gabesk/xmascard_lattice/board/schematic.pdf

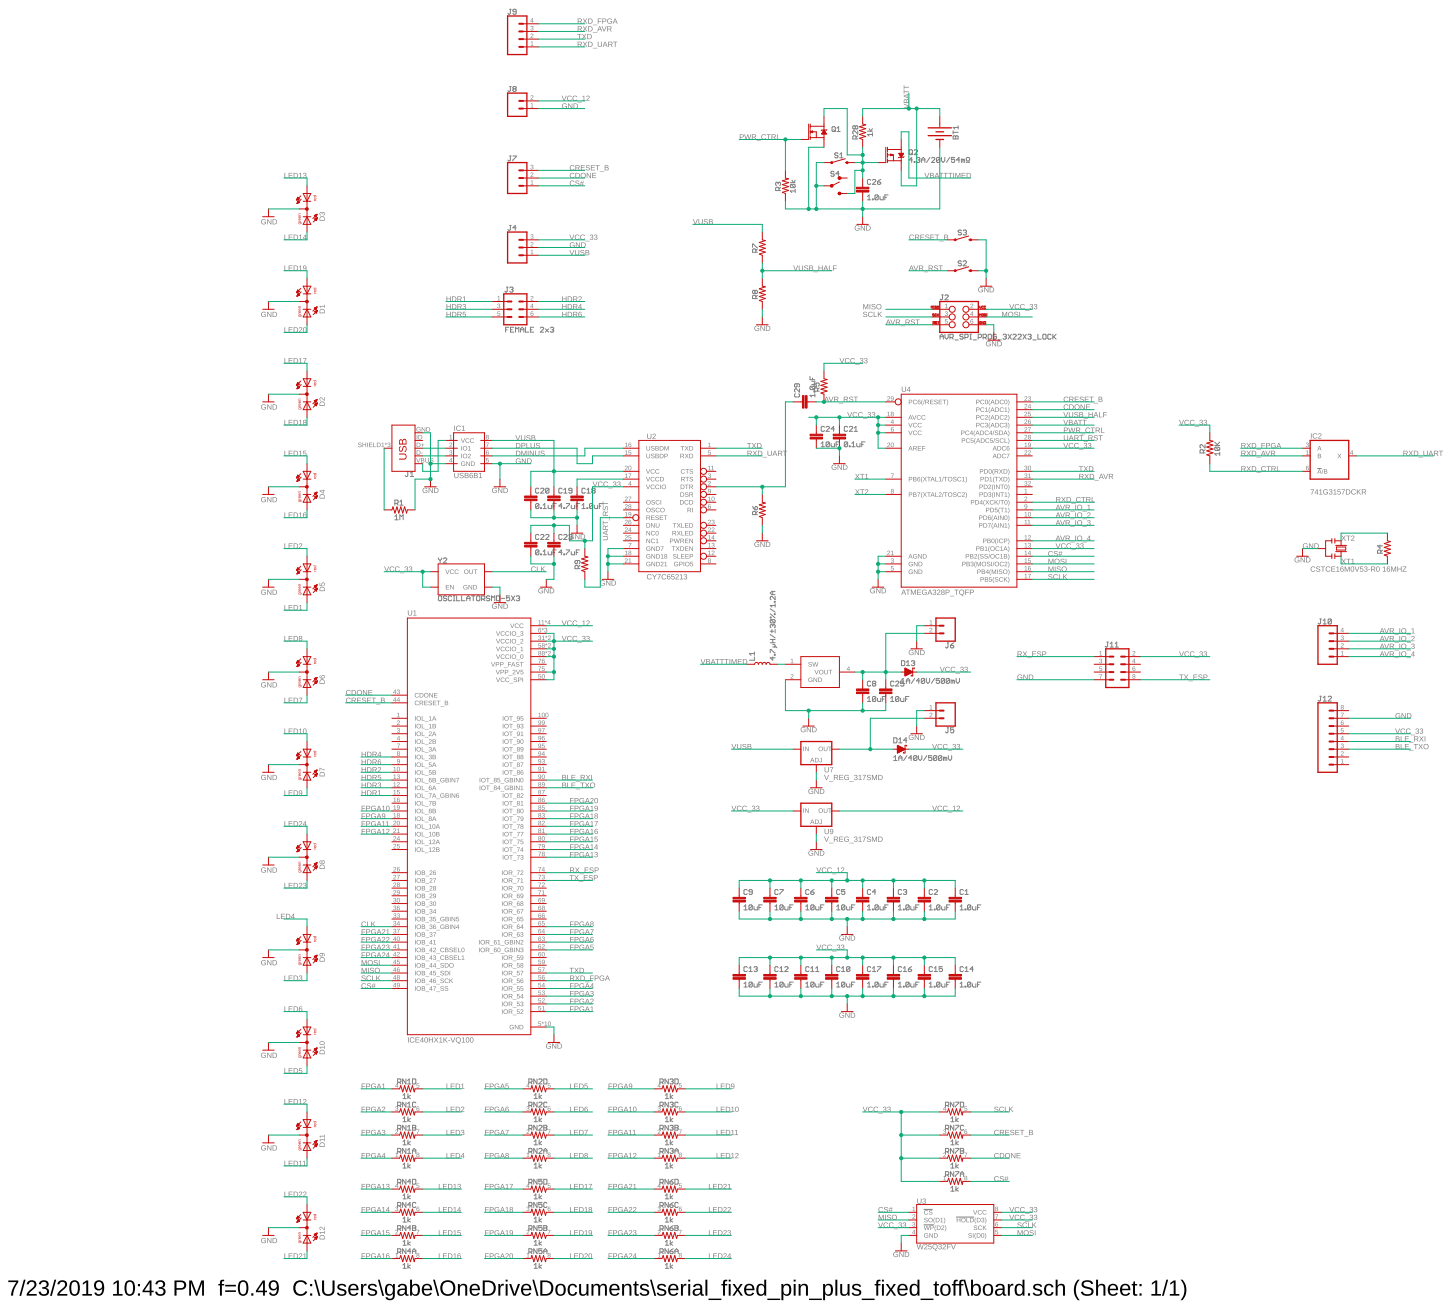
[picture p1: page 1]
