gabesk/xmascard_lattice/board/board.pdf

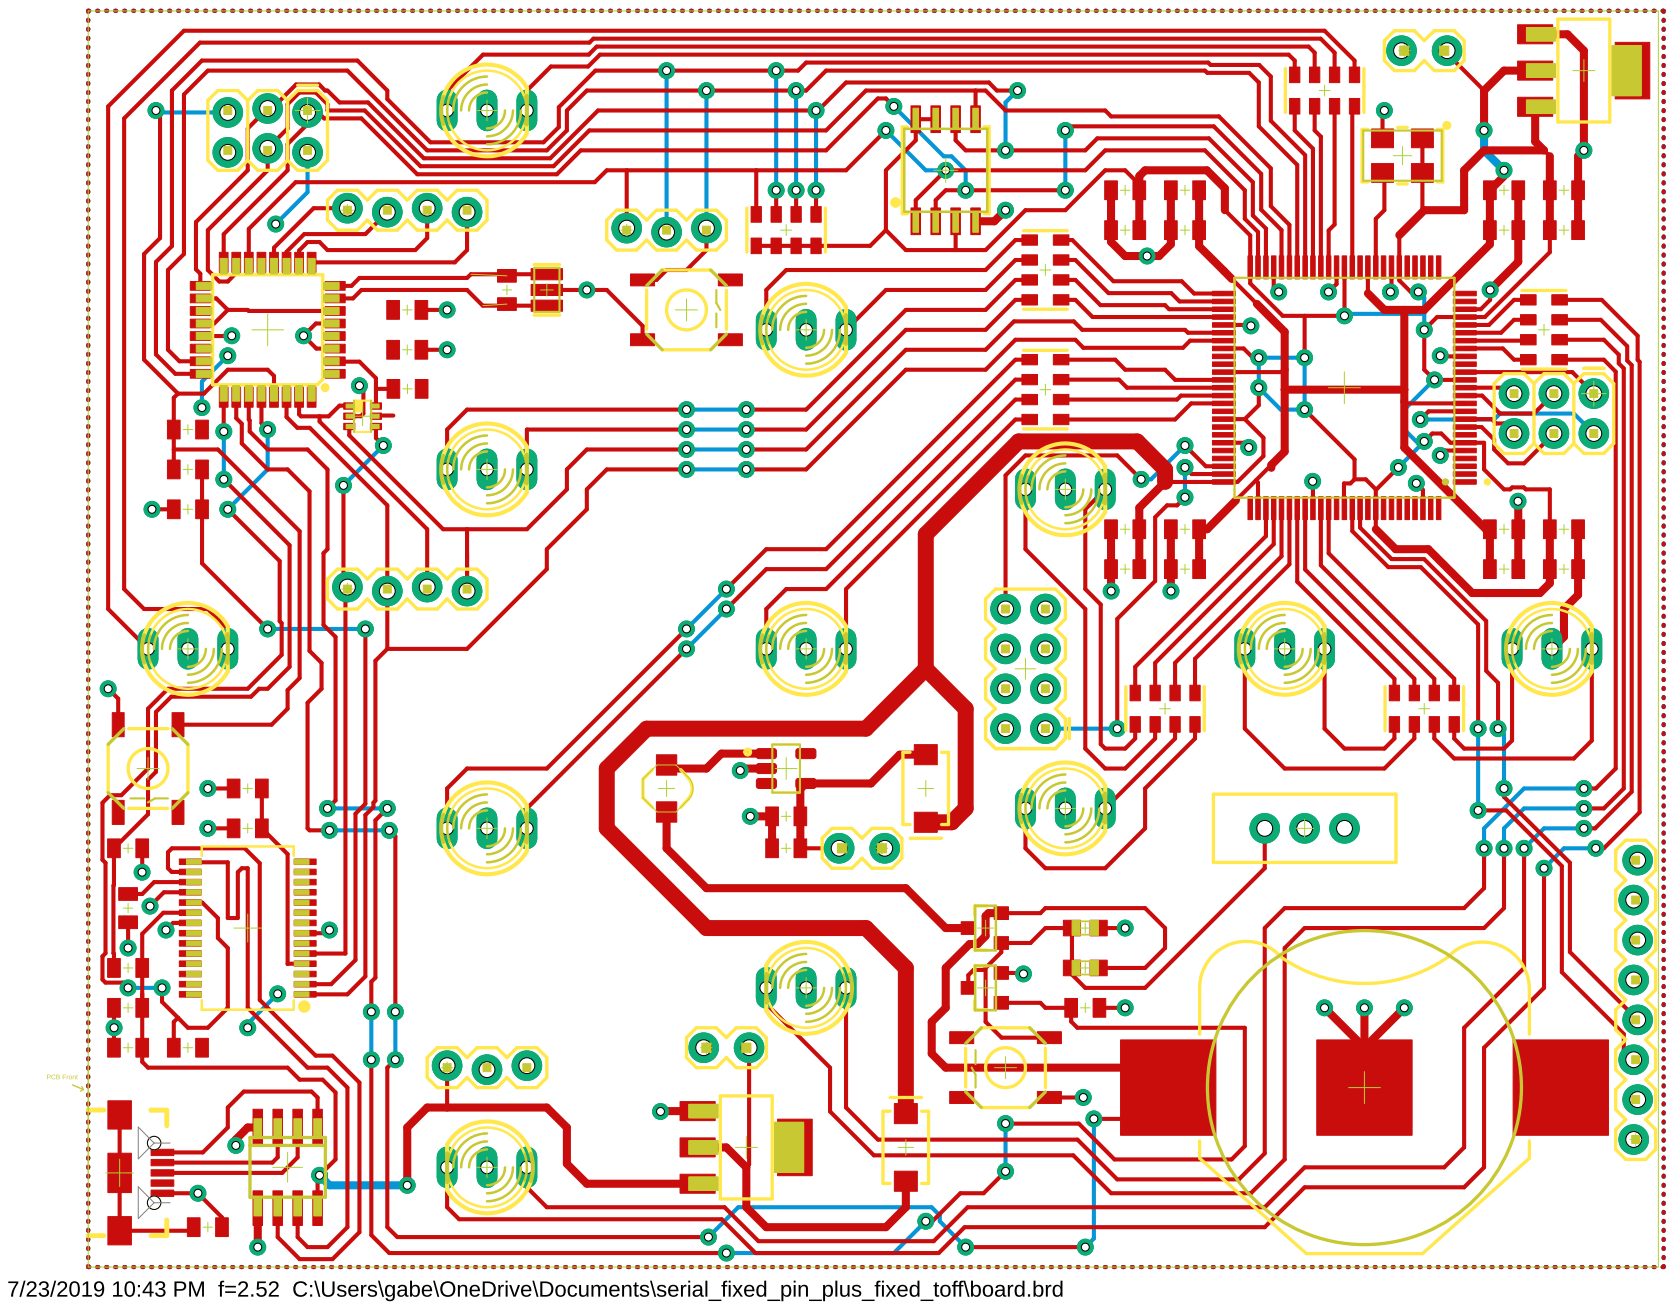
[picture p2: page 1]
