gabesk/xmascard_lattice/board/board.brd

## EAGLE design board/board.brd (2019-07-24)

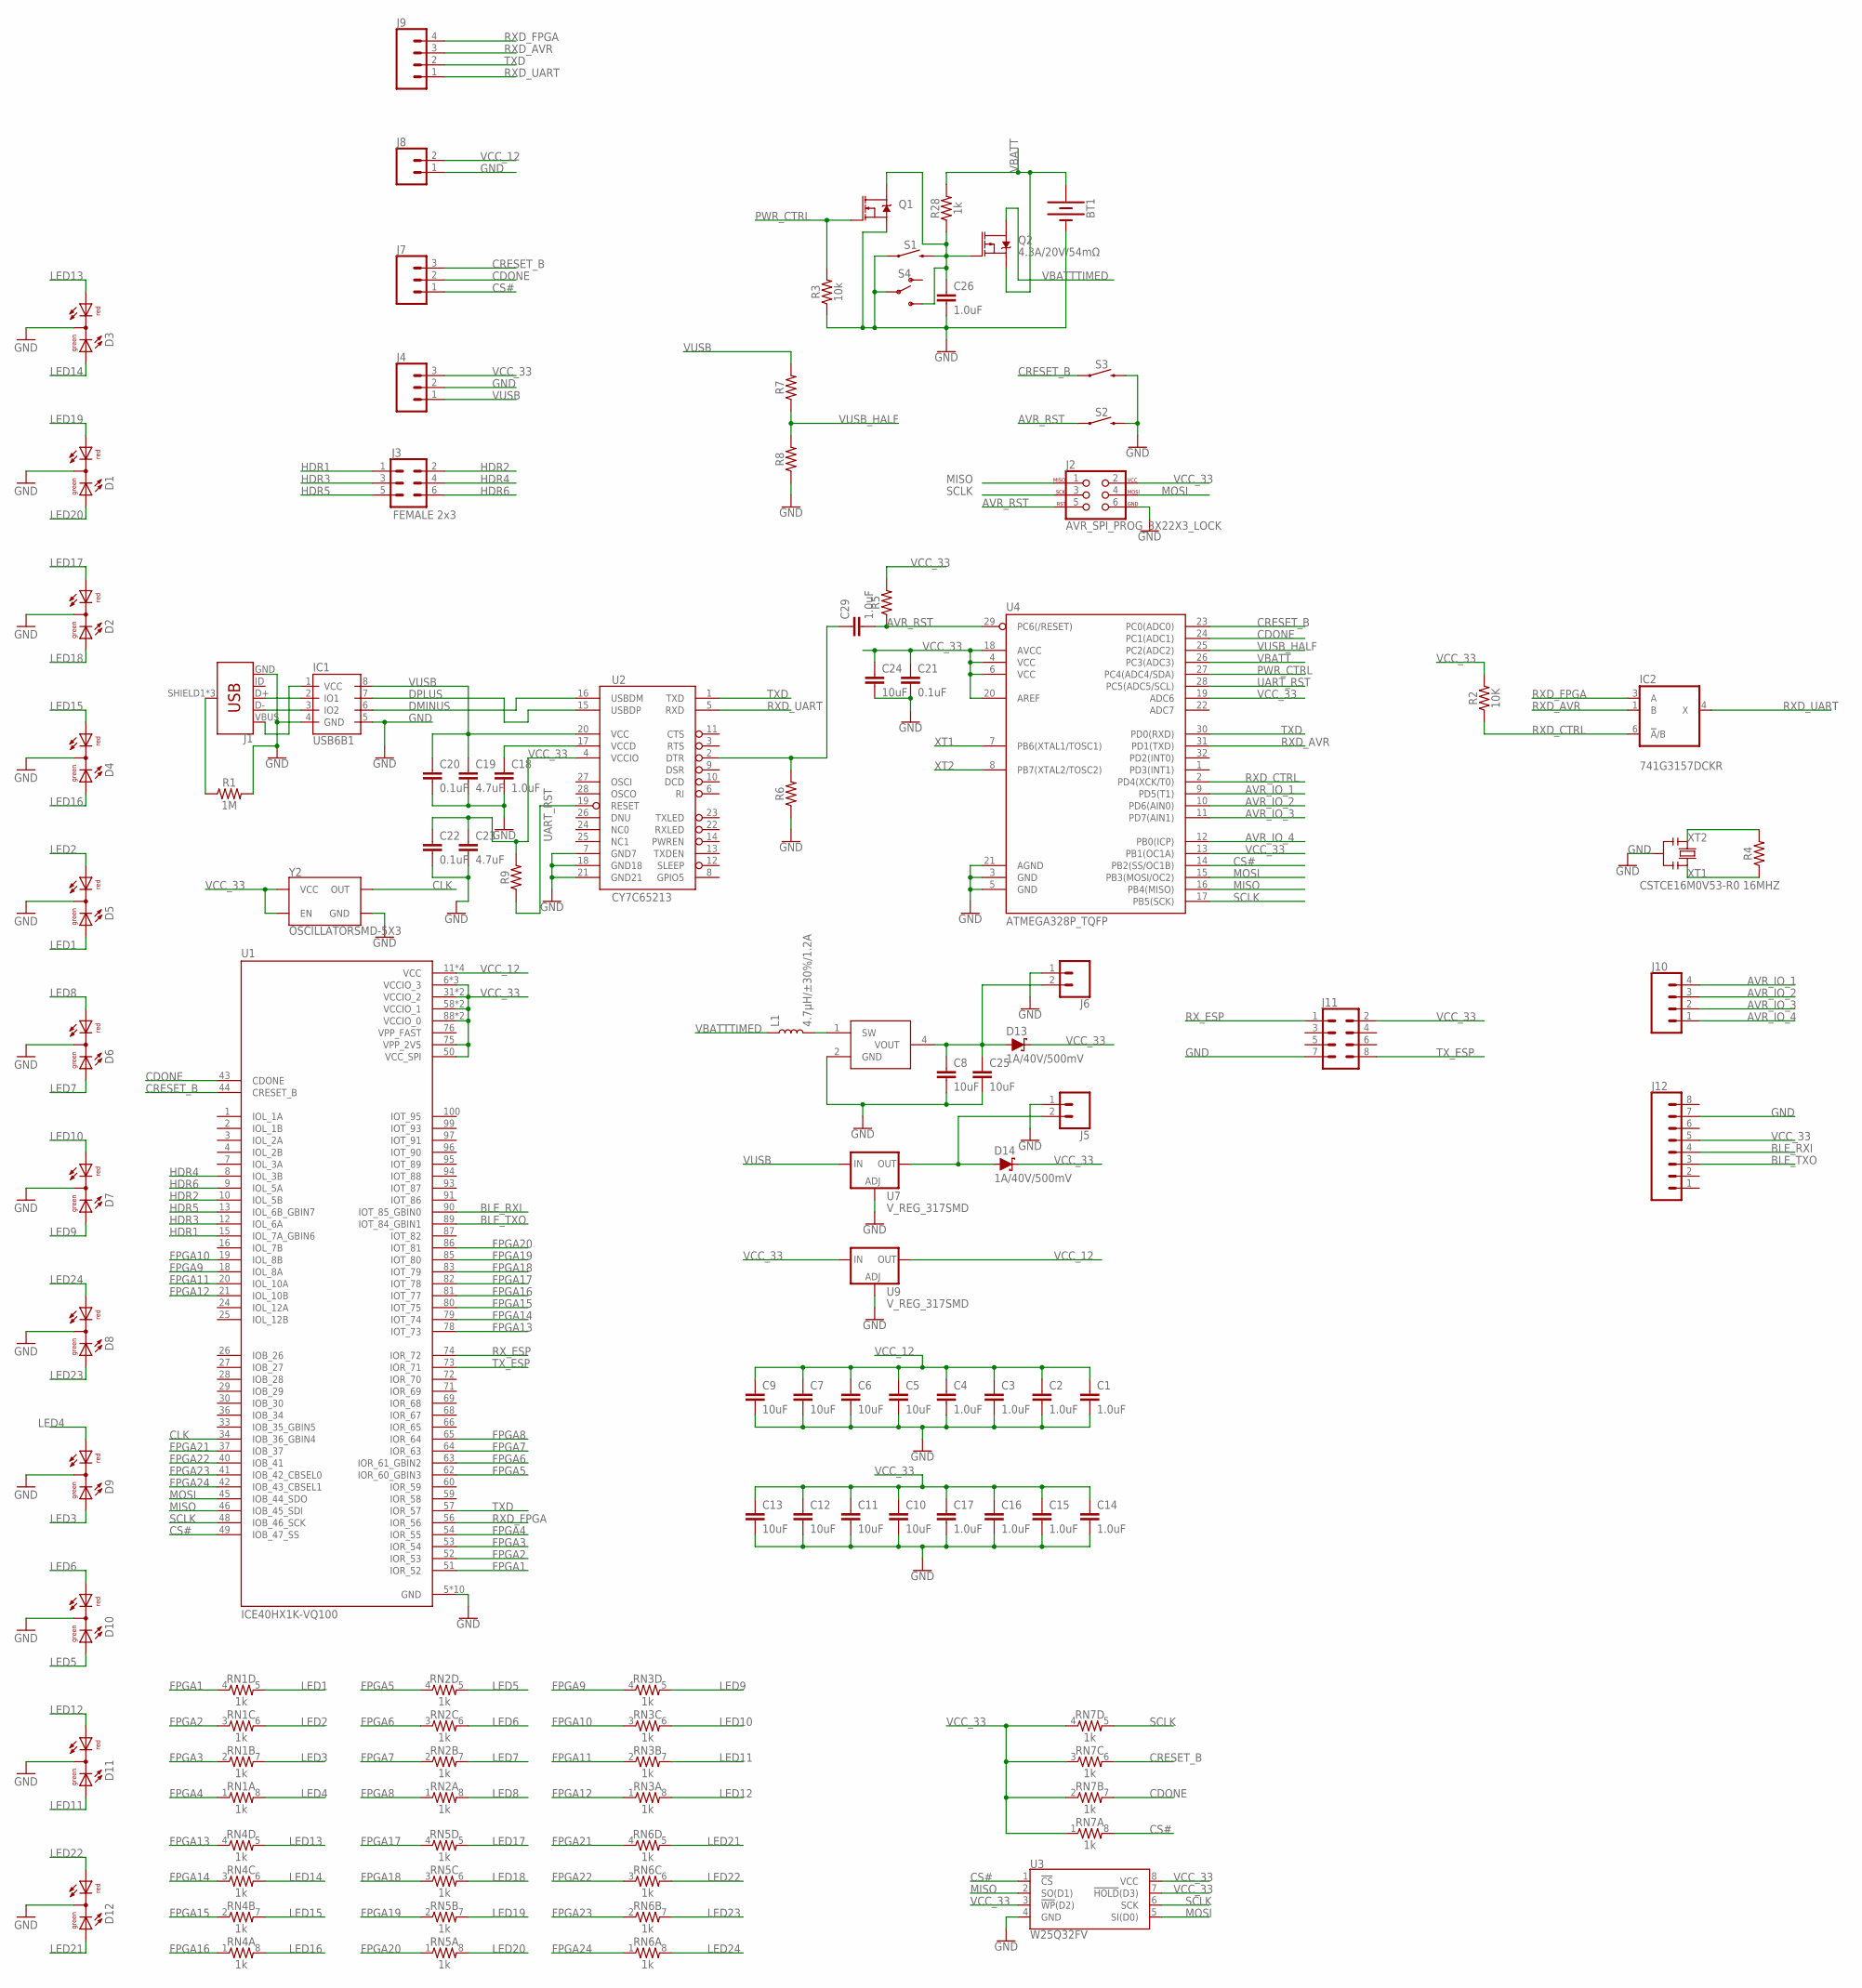
[picture p3: schematic board.sch]

Parts:
BT1: BATTERY-20MM_SMD; BATTCON_20MM
C1, C2, C3, C4, C14, C15, C16, C17, C18, C29: 1.0uF; 0805
C5, C6, C7, C8, C9, C10, C11, C12, C13, C24, C25: 10uF; 0805
C19, C23: 4.7uF; 0805
C20, C21, C22: 0.1uF; 0805
C26: 1.0uF; 0603
D1, D2, D3, D4, D5, D6, D7, D8, D9, D10, D11, D12: DUOLED5MM
D13, D14: 1A/40V/500mV; SMA-DIODE
IC1: USB6B1; SO08
IC2: 741G3157DCKR; DCK_R-PDSO-G6
J1: USB_MICRO-B_FEMALE-SMT; USB-B-MICRO-SMD
J2: AVR_SPI_PROG_3X22X3_LOCK; 2X3_LOCK
J3: FEMALE 2x3; 2X3
J4, J7: CONN_03LOCK; 1X03_LOCK
J5, J6, J8: CONN_02LOCK; 1X02_LOCK
J9, J10: CONN_04LOCK; 1X04_LOCK
J11: CONN_04X2; 2X4
J12: CONN_08LOCK; 1X08_LOCK
L1: 4.7µH/±30%/1.2A; INDUCTOR_4.7UH
Q1: 5.8A/30V/35mΩ; SOT23-3
Q2: 4.3A/20V/54mΩ; SOT23-3
R1: 1M; 0805
R2: 10K; 0805
R3: 10k; 0805
R4, R5, R6, R7, R8, R9: 0805
R28: 1k; 0603
RN1, RN2, RN3, RN4, RN5, RN6, RN7: 1k; 0805-ARV
S1, S2, S3: MOMENTARY-SWITCH-SPST-SMD-5.2MM; TACTILE_SWITCH_SMD_5.2MM
S4: SWITCH-SPDT-PTH-11.6X4.0MM; SWITCH_SPDT_PTH_11.6X4.0MM
U1: ICE40HX1K-VQ100; QFP50P1600X1600X120-100N
U2: CY7C65213; SSOP28DB
U3: W25Q32FV; SOIC-8
U4: ATMEGA328P_TQFP; TQFP32-08
U7, U9: V_REG_317SMD; SOT223
U$2: TPS613221A; SOT95P280X145-5N
Y1: CSTCE16M0V53-R0 16MHZ; RESONATOR
Y2: OSCILLATORSMD-5X3; OSCILLATOR-SMD-5X3.2

Connections:
AVR_IO_1: J10.4, U4.9 (PD5(T1))
AVR_IO_2: J10.3, U4.10 (PD6(AIN0))
AVR_IO_3: J10.2, U4.11 (PD7(AIN1))
AVR_IO_4: J10.1, U4.12 (PB0(ICP))
AVR_RST: C29.2, J2.5, R5.1, S2.1, U4.29 (PC6(/RESET))
BLE_RXI: J12.4, U1.90 (IOT_85_GBIN0)
BLE_TXO: J12.3, U1.89 (IOT_84_GBIN1)
CDONE: J7.2, RN7.7 (2), U1.43 (CDONE), U4.24 (PC1(ADC1))
CLK: U1.34 (IOB_36_GBIN4), Y2.3 (OUT)
CRESET_B: J7.3, RN7.6 (2), S3.1, U1.44 (CRESET_B), U4.23 (PC0(ADC0))
CS#: J7.1, RN7.8 (2), U1.49 (IOB_47_SS), U3.1 (!CS!), U4.14 (PB2(SS/OC1B))
DMINUS: IC1.6 (IO2), U2.16 (USBDM)
DPLUS: IC1.7 (IO1), U2.15 (USBDP)
FPGA1: RN1.4 (1), U1.51 (IOR_52)
FPGA2: RN1.3 (1), U1.52 (IOR_53)
FPGA3: RN1.2 (1), U1.53 (IOR_54)
FPGA4: RN1.1, U1.54 (IOR_55)
FPGA5: RN2.4 (1), U1.62 (IOR_60_GBIN3)
FPGA6: RN2.3 (1), U1.63 (IOR_61_GBIN2)
FPGA7: RN2.2 (1), U1.64 (IOR_63)
FPGA8: RN2.1, U1.65 (IOR_64)
FPGA9: RN3.4 (1), U1.18 (IOL_8A)
FPGA10: RN3.3 (1), U1.19 (IOL_8B)
FPGA11: RN3.2 (1), U1.20 (IOL_10A)
FPGA12: RN3.1, U1.21 (IOL_10B)
FPGA13: RN4.4 (1), U1.78 (IOT_73)
FPGA14: RN4.3 (1), U1.79 (IOT_74)
FPGA15: RN4.2 (1), U1.80 (IOT_75)
FPGA16: RN4.1, U1.81 (IOT_77)
FPGA17: RN5.4 (1), U1.82 (IOT_78)
FPGA18: RN5.3 (1), U1.83 (IOT_79)
FPGA19: RN5.2 (1), U1.85 (IOT_80)
FPGA20: RN5.1, U1.86 (IOT_81)
FPGA21: RN6.4 (1), U1.37 (IOB_37)
FPGA22: RN6.3 (1), U1.40 (IOB_41)
FPGA23: RN6.2 (1), U1.41 (IOB_42_CBSEL0)
FPGA24: RN6.1, U1.42 (IOB_43_CBSEL1)
GND: BT1.2 (-), C1.2, C2.2, C3.2, C4.2, C5.2, C6.2, C7.2, C8.2, C9.2, C10.2, C11.2, C12.2, C13.2, C14.2, C15.2, C16.2, C17.2, C18.2, C19.2, C20.2, C21.2, C22.2, C23.2, C24.2, C25.2, C26.2, D1.K (C), D2.K (C), D3.K (C), D4.K (C), D5.K (C), D6.K (C), D7.K (C), D8.K (C), D9.K (C), D10.K (C), D11.K (C), D12.K (C), IC1.4 (GND), IC1.5 (GND), IC2.2 (GND), J1.GND, J2.6, J4.2, J5.1, J6.1, J8.1, J11.7, J12.7, Q1.2 (S), R1.2, R3.1, R6.1, R8.1, S1.1, S2.3 (2), S3.3 (2), S4.2, U1.5 (GND), U1.17 (GND), U1.23 (GND), U1.32 (GND), U1.39 (GND), U1.47 (GND), U1.55 (GND), U1.70 (GND), U1.84 (GND), U1.98 (GND), U2.7 (GND7), U2.18 (GND18), U2.21 (GND21), U3.4 (GND), U4.3 (GND), U4.5 (GND), U4.21 (AGND), U7.1 (ADJ), U9.1 (ADJ), U$2.2 (GND), Y1.2, Y2.2 (GND)
HDR1: J3.1, U1.15 (IOL_7A_GBIN6)
HDR2: J3.2, U1.10 (IOL_5B)
HDR3: J3.3, U1.12 (IOL_6A)
HDR4: J3.4, U1.8 (IOL_3B)
HDR5: J3.5, U1.13 (IOL_6B_GBIN7)
HDR6: J3.6, U1.9 (IOL_5A)
LED1: D5.AG, RN1.5 (2)
LED2: D5.AR, RN1.6 (2)
LED3: D9.AG, RN1.7 (2)
LED4: D9.AR, RN1.8 (2)
LED5: D10.AG, RN2.5 (2)
LED6: D10.AR, RN2.6 (2)
LED7: D6.AG, RN2.7 (2)
LED8: D6.AR, RN2.8 (2)
LED9: D7.AG, RN3.5 (2)
LED10: D7.AR, RN3.6 (2)
LED11: D11.AG, RN3.7 (2)
LED12: D11.AR, RN3.8 (2)
LED13: D3.AR, RN4.5 (2)
LED14: D3.AG, RN4.6 (2)
LED15: D4.AR, RN4.7 (2)
LED16: D4.AG, RN4.8 (2)
LED17: D2.AR, RN5.5 (2)
LED18: D2.AG, RN5.6 (2)
LED19: D1.AR, RN5.7 (2)
LED20: D1.AG, RN5.8 (2)
LED21: D12.AG, RN6.5 (2)
LED22: D12.AR, RN6.6 (2)
LED23: D8.AG, RN6.7 (2)
LED24: D8.AR, RN6.8 (2)
MISO: J2.1, U1.46 (IOB_45_SDI), U3.2 (SO(D1)), U4.16 (PB4(MISO))
MOSI: J2.4, U1.45 (IOB_44_SDO), U3.5 (SI(D0)), U4.15 (PB3(MOSI/OC2))
unnamed: C29.1, R6.2, U2.2 (DTR)
unnamed: C8.1, C25.1, D13.A, J6.2, U$2.4 (VOUT)
unnamed: C18.1, U2.17 (VCCD)
unnamed: J1.SHIELD1 (SHIELD), J1.SHIELD2 (SHIELD), J1.SHIELD3 (SHIELD), R1.1
unnamed: C26.1, Q1.3 (D), Q2.1 (G), R28.1, S1.3 (2), S4.3 (S)
unnamed: D14.A, J5.2, U7.2 (OUT)
unnamed: IC1.2 (IO1), J1.D+
unnamed: IC1.3 (IO2), J1.D-
unnamed: L1.P$2 (2), U$2.1 (SW)
unnamed: IC1.1 (VCC), J1.VBUS
NC1: U2.25 (NC1)
PWR_CTRL: Q1.1 (G), R3.2, U4.27 (PC4(ADC4/SDA))
RXD_AVR: IC2.1 (B), J9.3, U4.31 (PD1(TXD))
RXD_CTRL: IC2.6 (!A!/B), R2.1, U4.2 (PD4(XCK/T0))
RXD_FPGA: IC2.3 (A), J9.4, U1.56 (IOR_56)
RXD_UART: IC2.4 (X), J9.1, U2.5 (RXD)
RX_ESP: J11.1, U1.74 (IOR_72)
SCLK: J2.3, RN7.5 (2), U1.48 (IOB_46_SCK), U3.6 (SCK), U4.17 (PB5(SCK))
TXD: J9.2, U1.57 (IOR_57), U2.1 (TXD), U4.30 (PD0(RXD))
TX_ESP: J11.8, U1.73 (IOR_71)
UART_RST: R9.1, U2.19 (RESET), U4.28 (PC5(ADC5/SCL))
VBATT: BT1.1 (+), Q2.2 (S), R28.2, U4.26 (PC3(ADC3))
VBATTTIMED: L1.P$1 (1), Q2.3 (D)
VCC_12: C1.1, C2.1, C3.1, C4.1, C5.1, C6.1, C7.1, C9.1, J8.2, U1.11 (VCC), U1.35 (VCC), U1.61 (VCC), U1.77 (VCC), U9.2 (OUT)
VCC_33: C10.1, C11.1, C12.1, C13.1, C14.1, C15.1, C16.1, C17.1, C21.1, C22.1, C23.1, C24.1, D13.C, D14.C, IC2.5 (VCC), J2.2, J4.3, J11.2, J12.5, R2.2, R5.2, R9.2, RN7.1, RN7.2 (1), RN7.3 (1), RN7.4 (1), U1.6 (VCCIO_3), U1.14 (VCCIO_3), U1.22 (VCCIO_3), U1.31 (VCCIO_2), U1.38 (VCCIO_2), U1.50 (VCC_SPI), U1.58 (VCCIO_1), U1.67 (VCCIO_1), U1.75 (VPP_2V5), U1.88 (VCCIO_0), U1.92 (VCCIO_0), U2.4 (VCCIO), U3.3 (!WP!(D2)), U3.7 (!HOLD!(D3)), U3.8 (VCC), U4.4 (VCC), U4.6 (VCC), U4.13 (PB1(OC1A)), U4.18 (AVCC), U4.19 (ADC6), U4.20 (AREF), U9.3 (IN), Y2.1 (EN), Y2.4 (VCC)
VPP_FAST: U1.76 (VPP_FAST)
VUSB: C19.1, C20.1, IC1.8 (VCC), J4.1, R7.2, U2.20 (VCC), U7.3 (IN)
VUSB_HALF: R7.1, R8.2, U4.25 (PC2(ADC2))
XT1: R4.1, U4.7 (PB6(XTAL1/TOSC1)), Y1.3
XT2: R4.2, U4.8 (PB7(XTAL2/TOSC2)), Y1.1

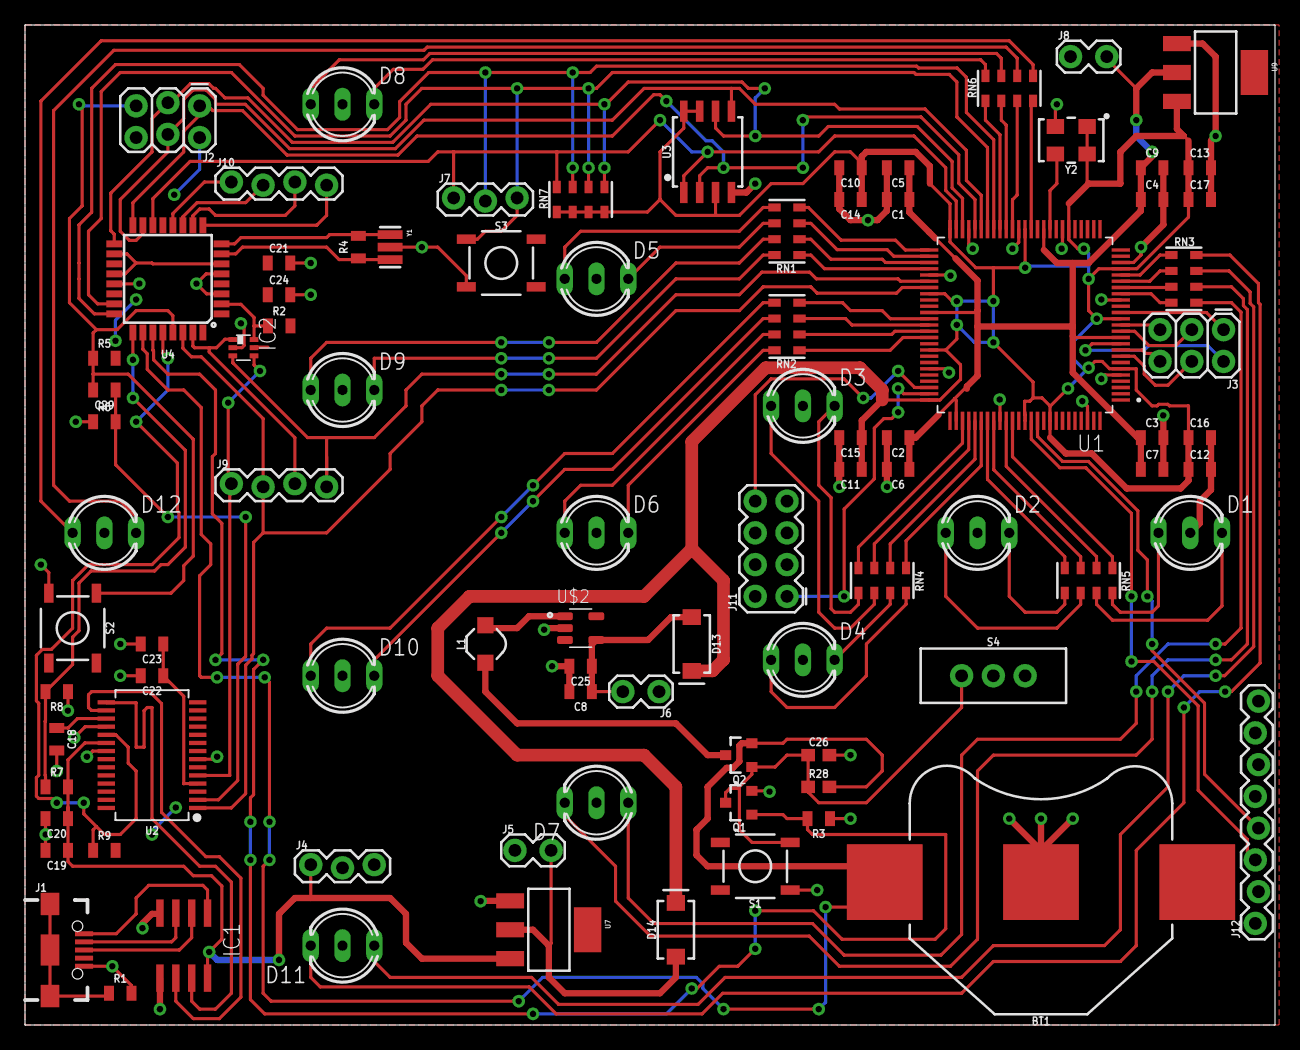
[picture p4: board board.brd from above]

Board: 2 copper layers, 100.0 x 80.0 mm, 89 parts (0 on the bottom side), 98 nets.
